Rchana/ParkinsonsProject/Process work/Hardware & prototype/circuit-design.jpg

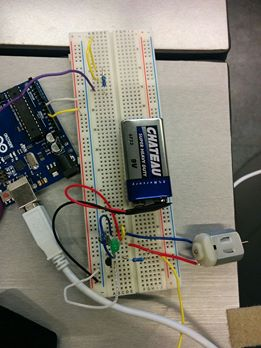
Process work/Hardware & prototype/circuit-design.jpg
