Rchana/ParkinsonsProject/Process work/Hardware & prototype/prototype-design.jpg

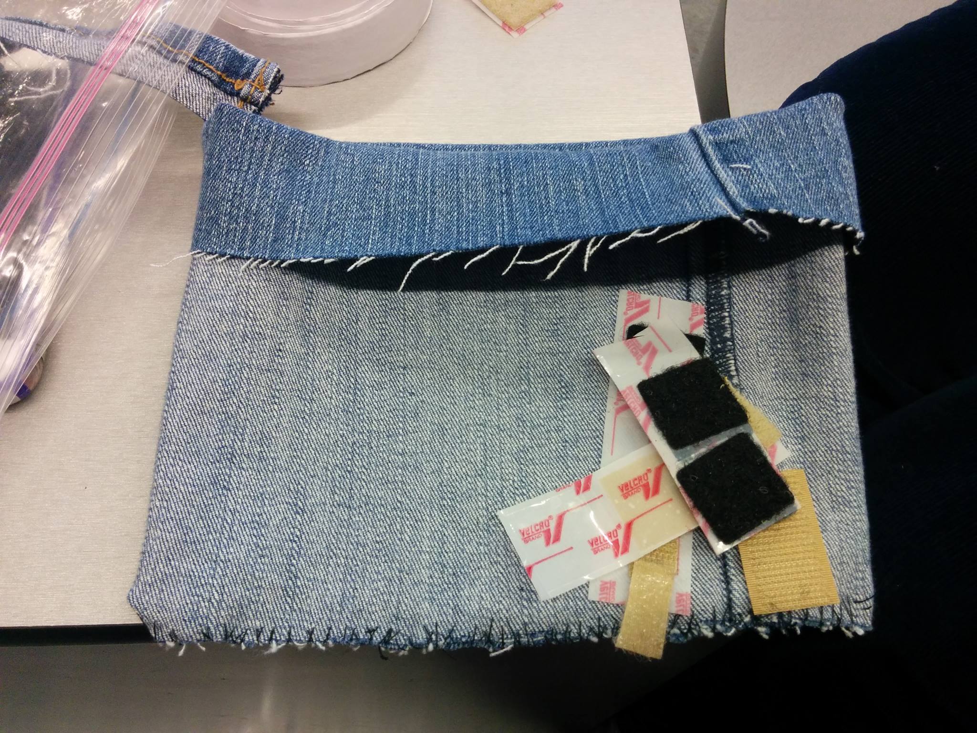
Process work/Hardware & prototype/prototype-design.jpg
