Rchana/ParkinsonsProject/Process work/debugging buzzer music/buzzer.ino

#include "pitches.h" //Header file with pitch definitions
const int SPEAKER=9; //Speaker Pin
//Note Array
int notes[] = {
NOTE_A4, NOTE_E3, NOTE_A4, 0,
NOTE_A4, NOTE_E3, NOTE_A4, 0,
NOTE_E4, NOTE_D4, NOTE_C4, NOTE_B4, NOTE_A4, NOTE_B4, NOTE_C4, NOTE_D4,
NOTE_E4, NOTE_E3, NOTE_A4, 0
};
//The Duration of each note (in ms)
int times[] = {
250, 250, 250, 250,
250, 250, 250, 250,
125, 125, 125, 125, 125, 125, 125, 125,
250, 250, 250, 250
};

void setup()
{
  //Play each note for the right duration
  for (int i = 0; i < 20; i++)
  {
  tone(SPEAKER, notes[i], times[i]);
  delay(times[i]);
  }
}

void loop()
{
//Press the Reset button to play again.
}
