Rchana/ParkinsonsProject/(commit log)

2016-11-24 IMU data files for developing detection algorithm
2016-11-24 folder reorganization, read IMU input
2016-11-24 added Arduino communication
2016-11-24 modification to imu data reading
2016-11-30 Converting over matlab signal detection onto arduino studio
2016-12-01 Addition of output devices, i.e. motor, led, buzzer
    [arduinoSignalDetection.ino]
2016-12-01 buzzer music to listen to while debugging & updated imu read input
    [buzzer.ino, read-imu-input.ino]
